Professor-plum/SAINTCON-BADGE-2026/README.md

# SAINTCON-BADGE-2026
Electronic badge for SAINTCON2026
