Professor-plum/SAINTCON-BADGE-2026/hardware/Apollo.kicad_pcb

## KiCad design hardware/Apollo.kicad_pcb (2026-10-26)

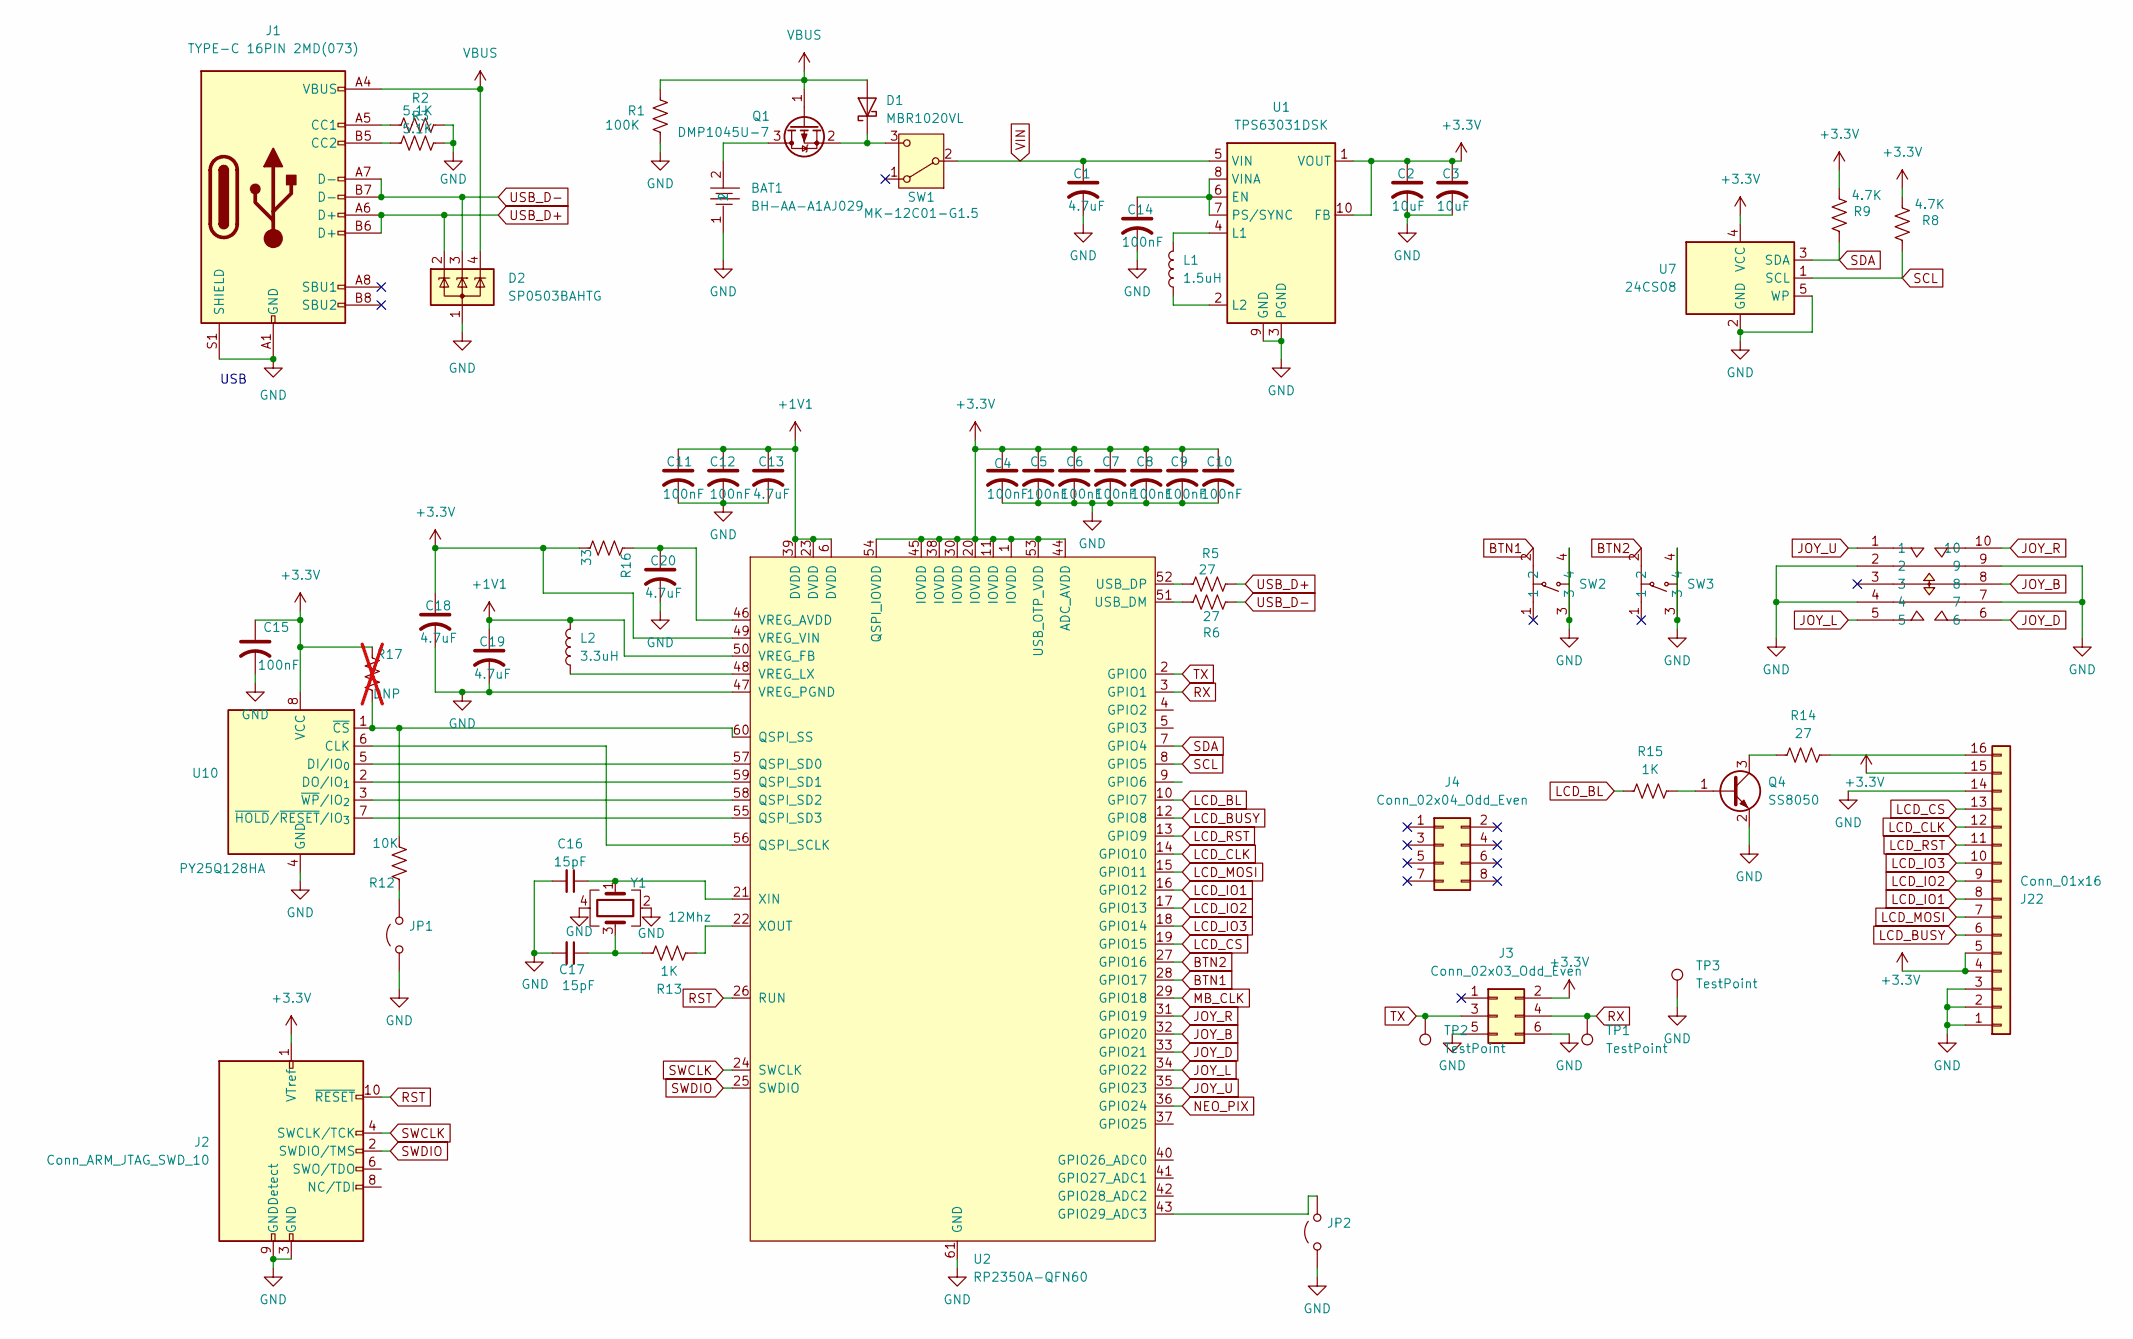
[picture p1: schematic mcu.kicad_sch, Apollo]

Parts:
BAT1: BH-AA-A1AJ029; BAT-TH_BH-AA-A1AJ029; LCSC Part C7525429
C1, C13, C18, C19, C20: 4.7uF; C_0603_1608Metric; LCSC Part C19666
C2, C3: 10uF; C_0603_1608Metric; LCSC Part C19702
C4, C5, C6, C7, C8, C9, C10, C11, C12, C14, C15: 100nF; C_0603_1608Metric; LCSC Part C1590
C16, C17: 15pF; C_0603_1608Metric; LCSC Part C1644
D1: MBR1020VL; D_SOD-123F; LCSC Part C49231015
D2: SP0503BAHTG; SOT-143; LCSC Part C7074
J1: TYPE-C 16PIN 2MD(073); USB_C_Receptacle_GCT_USB4105-xx-A_16P_TopMnt_Horizontal; LCSC Part C2765186
J2: Conn_ARM_JTAG_SWD_10; PinHeader_2x05_P1.27mm_Vertical_SMD
J3: Conn_02x03_Odd_Even; PCB_Edge_6
J4: Conn_02x04_Odd_Even; PCB_Edge_8
J22: Conn_01x16; FPC-SMD_16P-P0.50_KH-FPC0.5-H1.0SMT-16P; LCSC Part C3250117
JP1, JP2: Jumper_2_Open; SolderJumper-2_P1.3mm_Open_RoundedPad1.0x1.5mm
L1: 1.5uH; IND-SMD_L3.0-W3.0_FNR30XXS; LCSC Part C167745
L2: 3.3uH; IND-SMD_L2.0-W1.6_AOTA-B201610S3R3-101-T; LCSC Part C42411119
Q1: DMP1045U-7; SOT-23; LCSC Part C177033
Q4: SS8050; SOT-23; LCSC Part C2914407
R1: 100K; R_0603_1608Metric; LCSC Part C25803
R2, R3: 5.1K; R_0603_1608Metric; LCSC Part C2907044
R5, R6, R14: 27; R_0603_1608Metric; LCSC Part C2907021
R8, R9: 4.7K; R_0603_1608Metric; LCSC Part C23162
R12: 10K; R_0603_1608Metric; LCSC Part C25804
R13, R15: 1K; R_0603_1608Metric; LCSC Part C5362357
R16: 33; R_0603_1608Metric; LCSC Part C23140
R17: DNP; R_0603_1608Metric; not fitted
SW1: MK-12C01-G1.5; SW-SMD_DEALON_MK-12C01-G1.5; LCSC Part C2904924
SW2, SW3: TS-1095PS-A1B2-C3D2; KEY-SMD_4P-L6.0-W6.0-P3.90-LS9.0; LCSC Part C2834918
SW4: LCK-TKLYABE0G1; SW-SMD_10P-L10.6-W10.0_SKLYABE010; MPN LCK-TKLYABE0G1; LCSC Part C54769749
TP1, TP2, TP3: TestPoint; TestPoint_Pad_D1.0mm
U1: TPS63031DSK; WSON-10-1EP_2.5x2.5mm_P0.5mm_EP1.2x2mm; LCSC Part C15516
U2: RP2350A-QFN60; QFN-60-1EP_7x7mm_P0.4mm_EP3.4x3.4mm; LCSC Part C42411118
U7: 24CS08; SOT-23-5; LCSC Part C41408502
U10: PY25Q128HA; SOIC-8_5.3x5.3mm_P1.27mm; LCSC Part C5354566
Y1: 12Mhz; CRYSTAL-SMD_4P-L3.2-W2.5-BL; LCSC Part C20625731

Connections:
+1V1: C11.1, C12.1, C13.1, C19.1, L2.2, U2.6 (DVDD), U2.23 (DVDD), U2.39 (DVDD), U2.50 (VREG_FB)
+3.3V: C2.1, C3.1, C4.1, C5.1, C6.1, C7.1, C8.1, C9.1, C10.1, C15.1, C18.1, J2.1 (VTref), J3.2, J22.4, J22.5, J22.15, R8.2, R9.2, R16.2, R17.1, U1.1 (VOUT), U1.10 (FB), U2.1 (IOVDD), U2.11 (IOVDD), U2.20 (IOVDD), U2.30 (IOVDD), U2.38 (IOVDD), U2.44 (ADC_AVDD), U2.45 (IOVDD), U2.49 (VREG_VIN), U2.53 (USB_OTP_VDD), U2.54 (QSPI_IOVDD), U7.4 (VCC), U10.8 (VCC); also elsewhere on the board
BTN1: SW2.2, U2.28 (GPIO17)
BTN2: SW3.2, U2.27 (GPIO16)
GND: BAT1.1, C1.2, C2.2, C3.2, C4.2, C5.2, C6.2, C7.2, C8.2, C9.2, C10.2, C11.2, C12.2, C13.2, C14.2, C15.2, C16.2, C17.2, C18.2, C19.2, C20.2, D2.1 (A), J1.A1 (GND), J1.A12 (GND), J1.B1 (GND), J1.B12 (GND), J1.S1 (SHIELD), J2.3 (GND), J2.5 (GND), J2.9 (GNDDetect), J3.5, J3.6, J22.1, J22.2, J22.3, J22.14, JP1.1 (A), JP2.1 (A), Q4.2 (E), R1.1, R2.2, R3.2, SW2.3, SW2.4, SW3.3, SW3.4, SW4.2, SW4.4, SW4.7, SW4.9, TP3.1 (1_1), U1.3 (PGND), U1.9 (GND), U1.11 (PGND), U2.47 (VREG_PGND), U2.61 (GND), U7.2 (GND), U7.5 (WP), U10.4 (GND), Y1.2, Y1.4; also elsewhere on the board
JOY_B: SW4.8, U2.32 (GPIO20)
JOY_D: SW4.6, U2.33 (GPIO21)
JOY_L: SW4.5, U2.34 (GPIO22)
JOY_R: SW4.10, U2.31 (GPIO19)
JOY_U: SW4.1, U2.35 (GPIO23)
LCD_BL: R15.1, U2.10 (GPIO7)
LCD_BUSY: J22.6, U2.12 (GPIO8)
LCD_CLK: J22.12, U2.14 (GPIO10)
LCD_CS: J22.13, U2.19 (GPIO15)
LCD_IO1: J22.8, U2.16 (GPIO12)
LCD_IO2: J22.9, U2.17 (GPIO13)
LCD_IO3: J22.10, U2.18 (GPIO14)
LCD_MOSI: J22.7, U2.15 (GPIO11)
LCD_RST: J22.11, U2.13 (GPIO9)
MB_CLK: U2.29 (GPIO18); also elsewhere on the board
NEO_PIX: U2.36 (GPIO24); also elsewhere on the board
unnamed: C17.1, R13.1, Y1.3
unnamed: D1.1 (K), Q1.2 (S), SW1.3 (C)
unnamed: J1.A5 (CC1), R2.1
unnamed: J1.B5 (CC2), R3.1
unnamed: J22.16, R14.2
unnamed: JP1.2 (B), R12.1
unnamed: JP2.2 (B), U2.43 (GPIO29_ADC3)
unnamed: BAT1.2, Q1.3 (D)
unnamed: Q4.1 (B), R15.2
unnamed: Q4.3 (C), R14.1
unnamed: C14.1, U1.6 (EN), U1.7 (PS/SYNC), U1.8 (VINA)
unnamed: L1.2, U1.4 (L1)
unnamed: L1.1, U1.2 (L2)
unnamed: R6.2, U2.51 (USB_DM)
unnamed: R5.1, U2.52 (USB_DP)
unnamed: C20.1, R16.1, U2.46 (VREG_AVDD)
unnamed: L2.1, U2.48 (VREG_LX)
unnamed: C16.1, U2.21 (XIN), Y1.1
unnamed: R13.2, U2.22 (XOUT)
unnamed: U2.56 (QSPI_SCLK), U10.6 (CLK)
unnamed: U2.57 (QSPI_SD0), U10.5 (DI/IO_{0})
unnamed: U2.59 (QSPI_SD1), U10.2 (DO/IO_{1})
unnamed: R12.2, R17.2, U2.60 (QSPI_SS), U10.1 (~CS)
unnamed: U2.55 (QSPI_SD3), U10.7 (~HOLD/~RESET/IO_{3})
unnamed: U2.58 (QSPI_SD2), U10.3 (~WP/IO_{2})
RST: J2.10 (~RESET), U2.26 (RUN)
RX: J3.4, TP1.1 (1_1), U2.3 (GPIO1)
SCL: R8.1, U2.8 (GPIO5), U7.1 (SCL); also elsewhere on the board
SDA: R9.1, U2.7 (GPIO4), U7.3 (SDA); also elsewhere on the board
SWCLK: J2.4 (SWCLK/TCK), U2.24 (SWCLK)
SWDIO: J2.2 (SWDIO/TMS), U2.25 (SWDIO)
TX: J3.3, TP2.1 (1_1), U2.2 (GPIO0)
USB_D+: D2.2 (K), J1.A6 (D+), J1.B6 (D+), R5.2
USB_D-: D2.3 (K), J1.A7 (D-), J1.B7 (D-), R6.1
VBUS: D1.2 (A), D2.4 (K), J1.A4 (VBUS), J1.A9 (VBUS), J1.B4 (VBUS), J1.B9 (VBUS), Q1.1 (G), R1.2
VIN: C1.1, SW1.2 (B), U1.5 (VIN)

Notes on the sheet:
USB

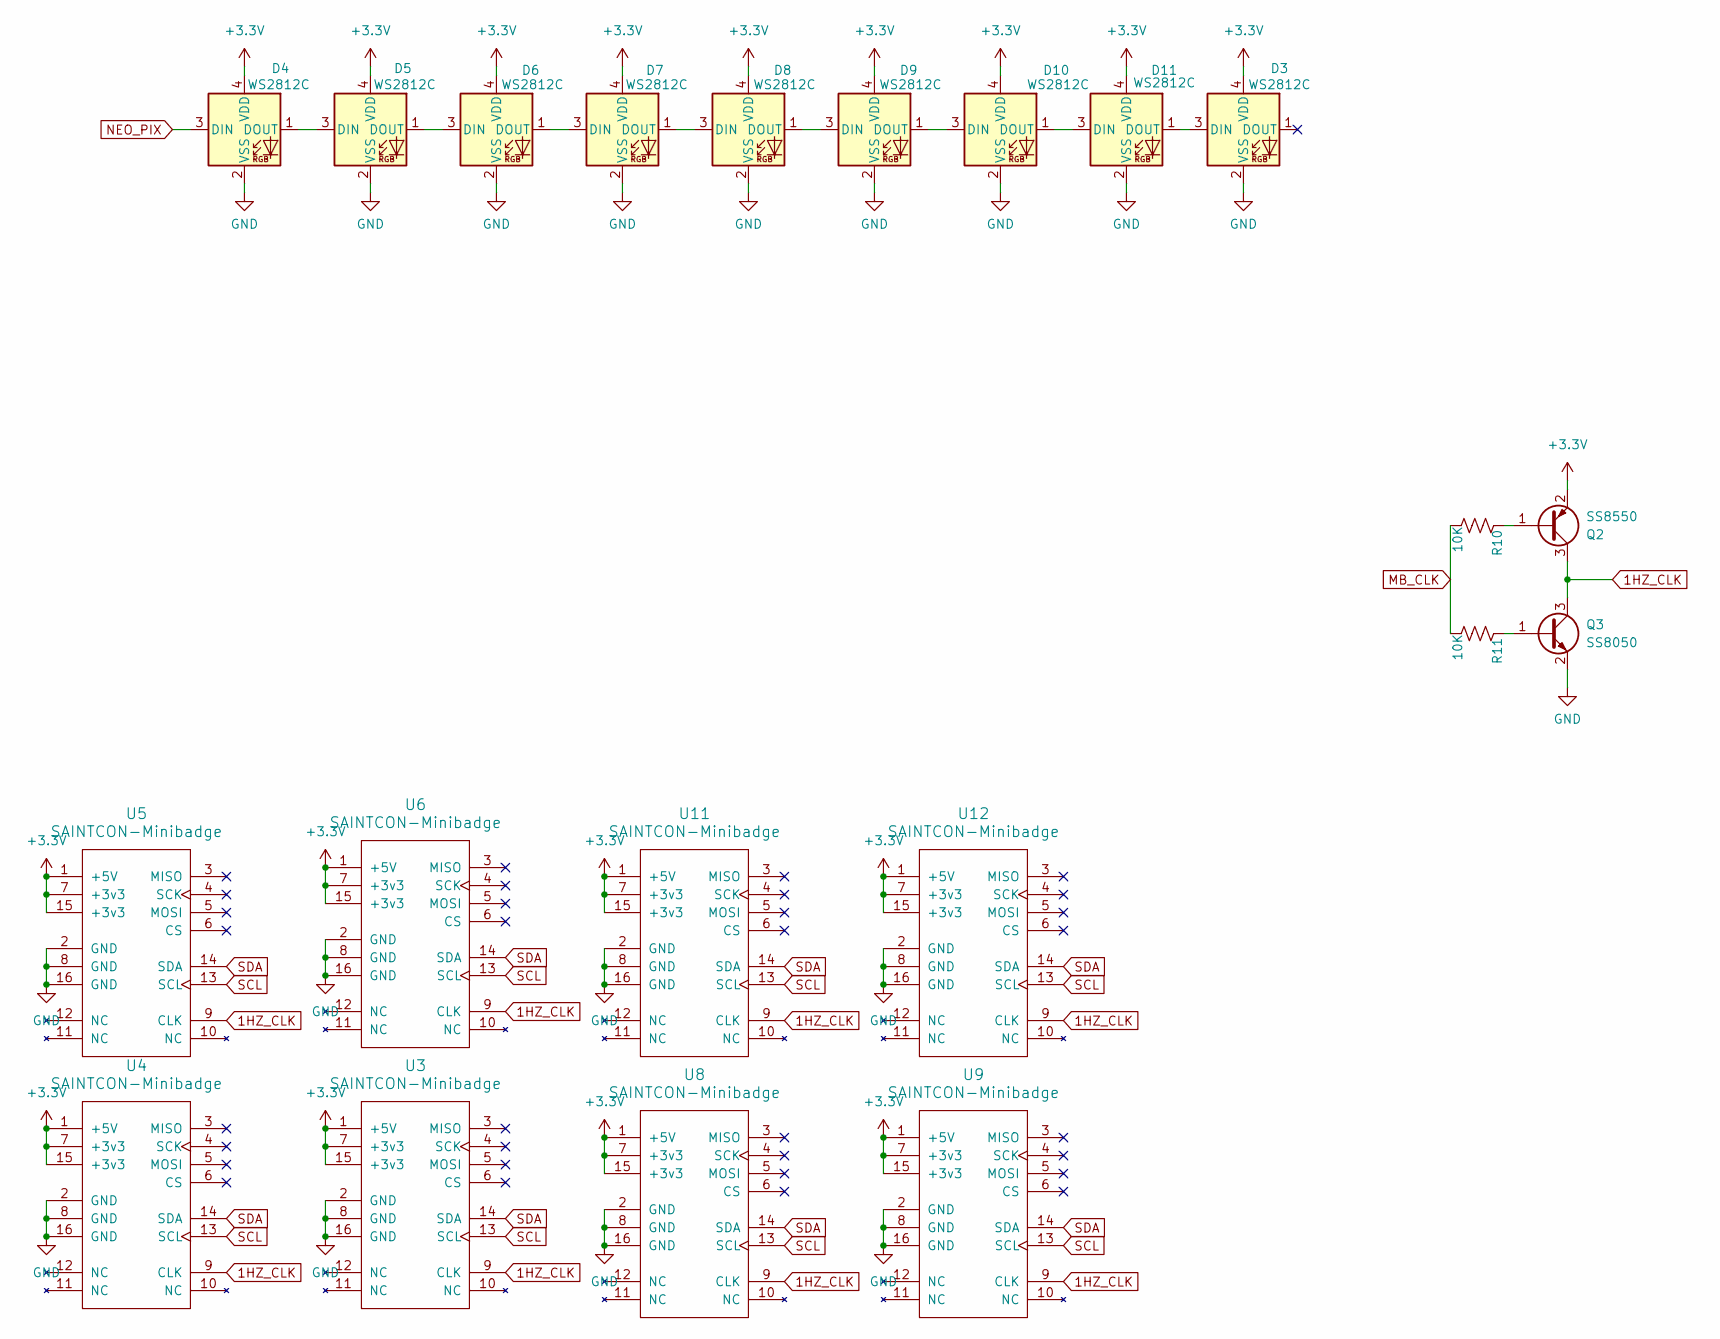
[picture p2: schematic i2c.kicad_sch, Apollo]

Parts:
D3, D4, D5, D6, D7, D8, D9, D10, D11: WS2812C; LED_WS2812B-2020_PLCC4_2.0x2.0mm; LCSC Part C2976072
Q2: SS8550; SOT-23; LCSC Part C916393
Q3: SS8050; SOT-23; LCSC Part C2914407
R10, R11: 10K; R_0603_1608Metric; LCSC Part C25804
U3, U4, U5, U6, U8, U9, U11, U12: SAINTCON-Minibadge; MiniBadge_Slot_Lock

Connections:
1HZ_CLK: Q2.3 (C), Q3.3 (C), U3.9 (CLK), U4.9 (CLK), U5.9 (CLK), U6.9 (CLK), U8.9 (CLK), U9.9 (CLK), U11.9 (CLK), U12.9 (CLK)
+3.3V: D3.4 (VDD), D4.4 (VDD), D5.4 (VDD), D6.4 (VDD), D7.4 (VDD), D8.4 (VDD), D9.4 (VDD), D10.4 (VDD), D11.4 (VDD), Q2.2 (E), U3.1 (+5V), U3.7 (+3v3), U3.15 (+3v3), U4.1 (+5V), U4.7 (+3v3), U4.15 (+3v3), U5.1 (+5V), U5.7 (+3v3), U5.15 (+3v3), U6.1 (+5V), U6.7 (+3v3), U6.15 (+3v3), U8.1 (+5V), U8.7 (+3v3), U8.15 (+3v3), U9.1 (+5V), U9.7 (+3v3), U9.15 (+3v3), U11.1 (+5V), U11.7 (+3v3), U11.15 (+3v3), U12.1 (+5V), U12.7 (+3v3), U12.15 (+3v3); also elsewhere on the board
GND: D3.2 (VSS), D4.2 (VSS), D5.2 (VSS), D6.2 (VSS), D7.2 (VSS), D8.2 (VSS), D9.2 (VSS), D10.2 (VSS), D11.2 (VSS), Q3.2 (E), U3.2 (GND), U3.8 (GND), U3.16 (GND), U4.2 (GND), U4.8 (GND), U4.16 (GND), U5.2 (GND), U5.8 (GND), U5.16 (GND), U6.2 (GND), U6.8 (GND), U6.16 (GND), U8.2 (GND), U8.8 (GND), U8.16 (GND), U9.2 (GND), U9.8 (GND), U9.16 (GND), U11.2 (GND), U11.8 (GND), U11.16 (GND), U12.2 (GND), U12.8 (GND), U12.16 (GND); also elsewhere on the board
MB_CLK: R10.2, R11.2; also elsewhere on the board
NEO_PIX: D4.3 (DIN); also elsewhere on the board
unnamed: D4.1 (DOUT), D5.3 (DIN)
unnamed: D5.1 (DOUT), D6.3 (DIN)
unnamed: D6.1 (DOUT), D7.3 (DIN)
unnamed: D7.1 (DOUT), D8.3 (DIN)
unnamed: D8.1 (DOUT), D9.3 (DIN)
unnamed: D9.1 (DOUT), D10.3 (DIN)
unnamed: D10.1 (DOUT), D11.3 (DIN)
unnamed: D3.3 (DIN), D11.1 (DOUT)
unnamed: Q2.1 (B), R10.1
unnamed: Q3.1 (B), R11.1
SCL: U3.13 (SCL), U4.13 (SCL), U5.13 (SCL), U6.13 (SCL), U8.13 (SCL), U9.13 (SCL), U11.13 (SCL), U12.13 (SCL); also elsewhere on the board
SDA: U3.14 (SDA), U4.14 (SDA), U5.14 (SDA), U6.14 (SDA), U8.14 (SDA), U9.14 (SDA), U11.14 (SDA), U12.14 (SDA); also elsewhere on the board

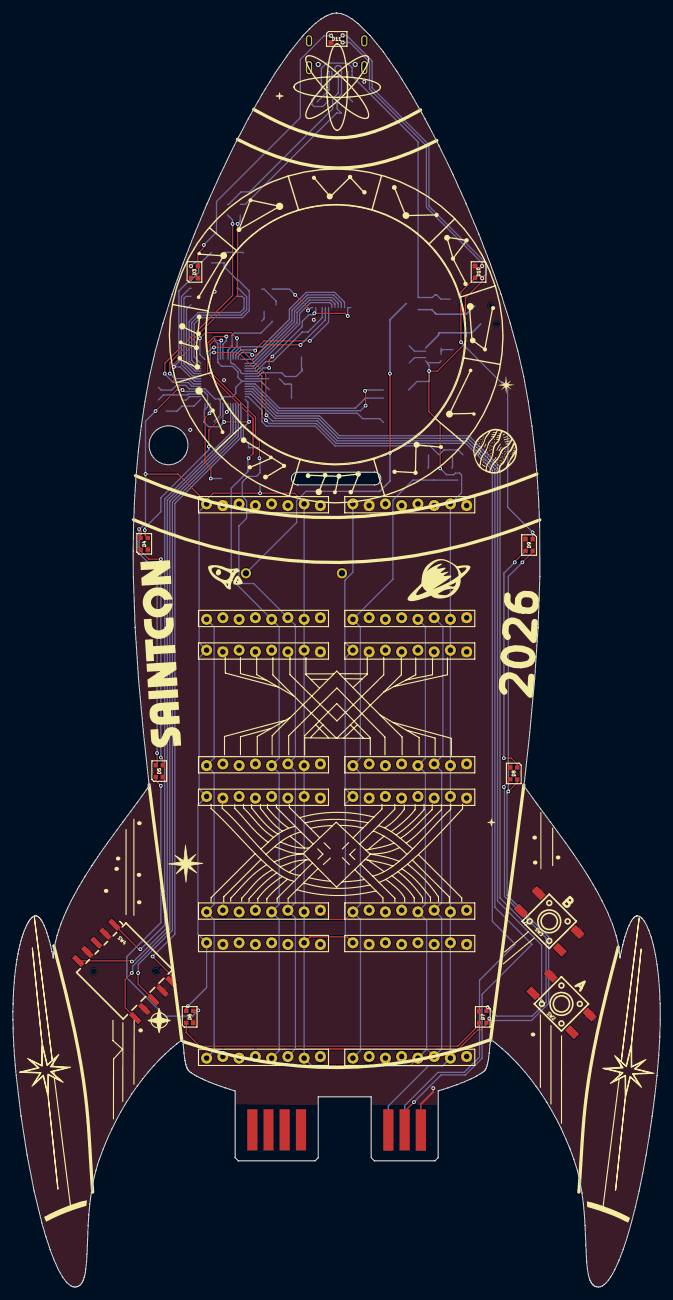
[picture p3: board Apollo.kicad_pcb from above]

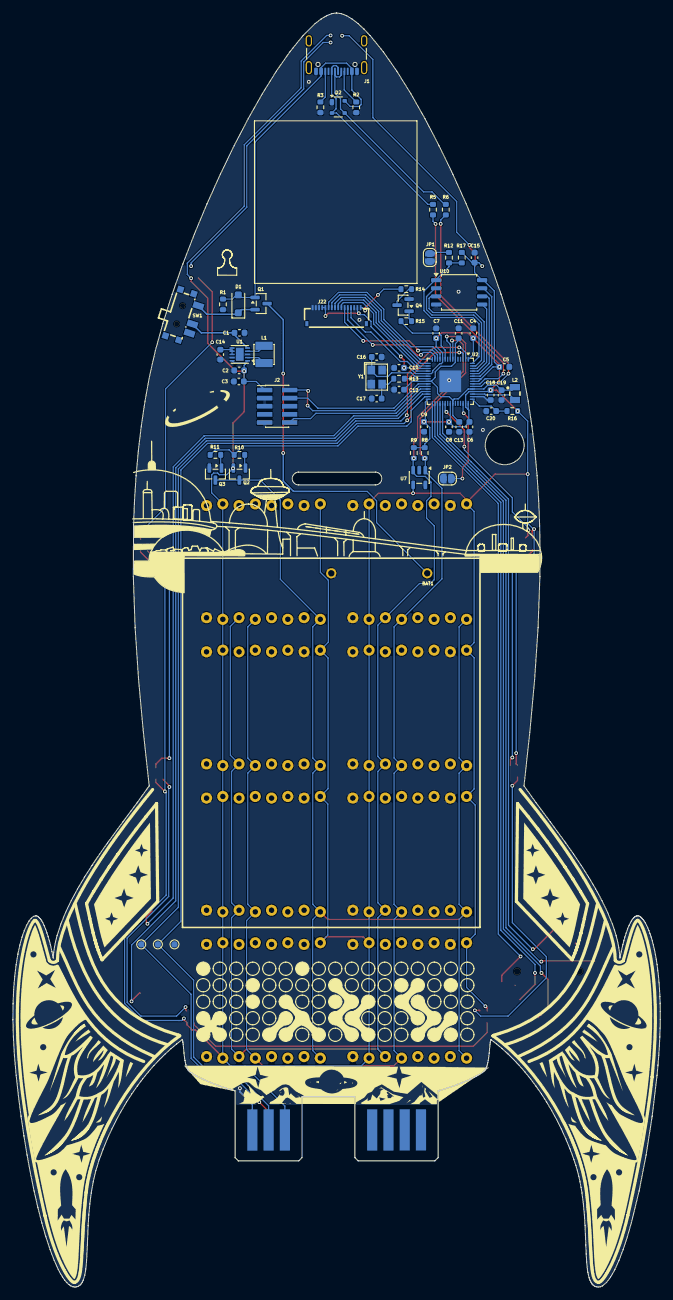
[picture p4: board Apollo.kicad_pcb from below]

Board: 2 copper layers, 101.2 x 199.1 mm, 80 parts (58 on the bottom side), 68 nets.
