Professor-plum/SAINTCON-BADGE-2026/hardware/Station/Station/Station.kicad_pcb

## KiCad design hardware/Station/Station/Station.kicad_pcb (2026-10-26)

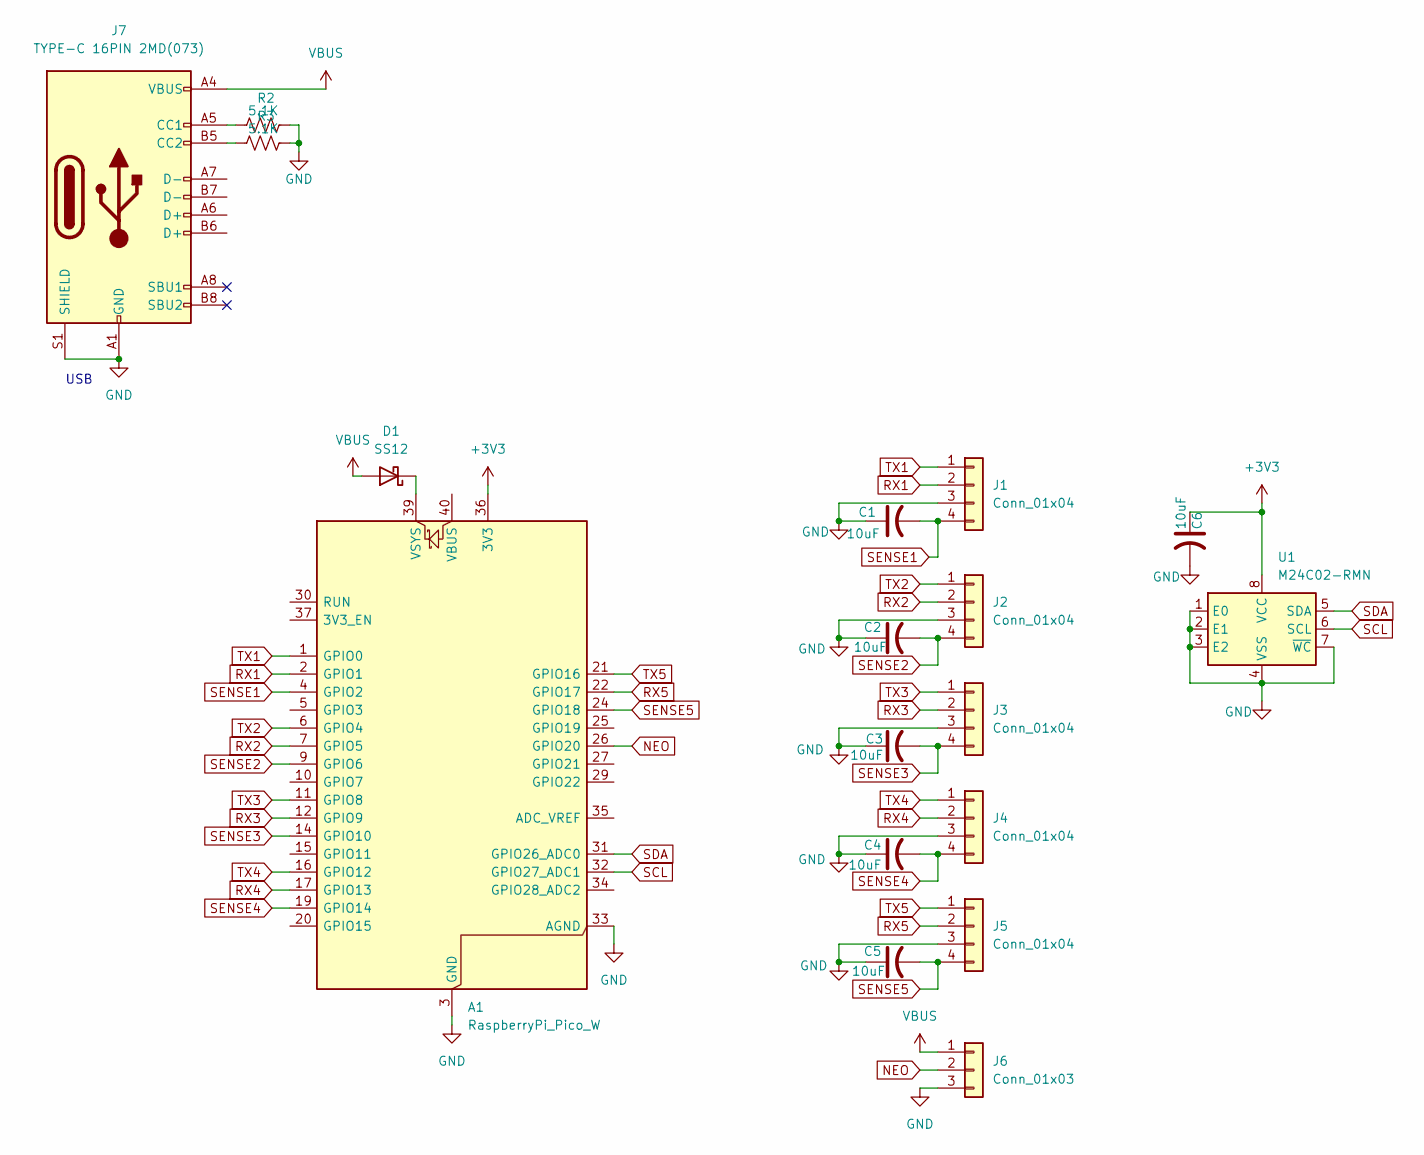
[picture p5: schematic Station.kicad_sch]

Parts:
A1: RaspberryPi_Pico_W; RaspberryPi_Pico_W_SMD_HandSolder
C1, C2, C3, C4, C5, C6: 10uF; C_0603_1608Metric_Pad1.08x0.95mm_HandSolder
D1: SS12; D_SMA
J1, J2, J3, J4, J5: Conn_01x04; PinHeader_1x04_P2.54mm_Vertical
J6: Conn_01x03; PinHeader_1x03_P2.54mm_Vertical
J7: TYPE-C 16PIN 2MD(073); USB_C_Receptacle_GCT_USB4105-xx-A_16P_TopMnt_Horizontal; LCSC Part C2765186
R2, R3: 5.1K; R_0603_1608Metric; LCSC Part C2907044
U1: M24C02-RMN; SOIC-8_3.9x4.9mm_P1.27mm

Connections:
+3V3: A1.36 (3V3), C6.1, U1.8 (VCC)
GND: A1.3 (GND), A1.8 (GND), A1.13 (GND), A1.18 (GND), A1.23 (GND), A1.28 (GND), A1.33 (AGND), A1.38 (GND), C1.1, C2.1, C3.1, C4.1, C5.1, C6.2, J1.3, J2.3, J3.3, J4.3, J5.3, J6.3, J7.A1 (GND), J7.A12 (GND), J7.B1 (GND), J7.B12 (GND), J7.S1 (SHIELD), R2.2, R3.2, U1.1 (E0), U1.2 (E1), U1.3 (E2), U1.4 (VSS), U1.7 (~WC)
NEO: A1.26 (GPIO20), J6.2
unnamed: A1.39 (VSYS), D1.1 (K)
unnamed: J7.A5 (CC1), R2.1
unnamed: J7.B5 (CC2), R3.1
RX1: A1.2 (GPIO1), J1.2
RX2: A1.7 (GPIO5), J2.2
RX3: A1.12 (GPIO9), J3.2
RX4: A1.17 (GPIO13), J4.2
RX5: A1.22 (GPIO17), J5.2
SCL: A1.32 (GPIO27_ADC1), U1.6 (SCL)
SDA: A1.31 (GPIO26_ADC0), U1.5 (SDA)
SENSE1: A1.4 (GPIO2), C1.2, J1.4
SENSE2: A1.9 (GPIO6), C2.2, J2.4
SENSE3: A1.14 (GPIO10), C3.2, J3.4
SENSE4: A1.19 (GPIO14), C4.2, J4.4
SENSE5: A1.24 (GPIO18), C5.2, J5.4
TX1: A1.1 (GPIO0), J1.1
TX2: A1.6 (GPIO4), J2.1
TX3: A1.11 (GPIO8), J3.1
TX4: A1.16 (GPIO12), J4.1
TX5: A1.21 (GPIO16), J5.1
VBUS: D1.2 (A), J6.1, J7.A4 (VBUS), J7.A9 (VBUS), J7.B4 (VBUS), J7.B9 (VBUS)

Notes on the sheet:
USB

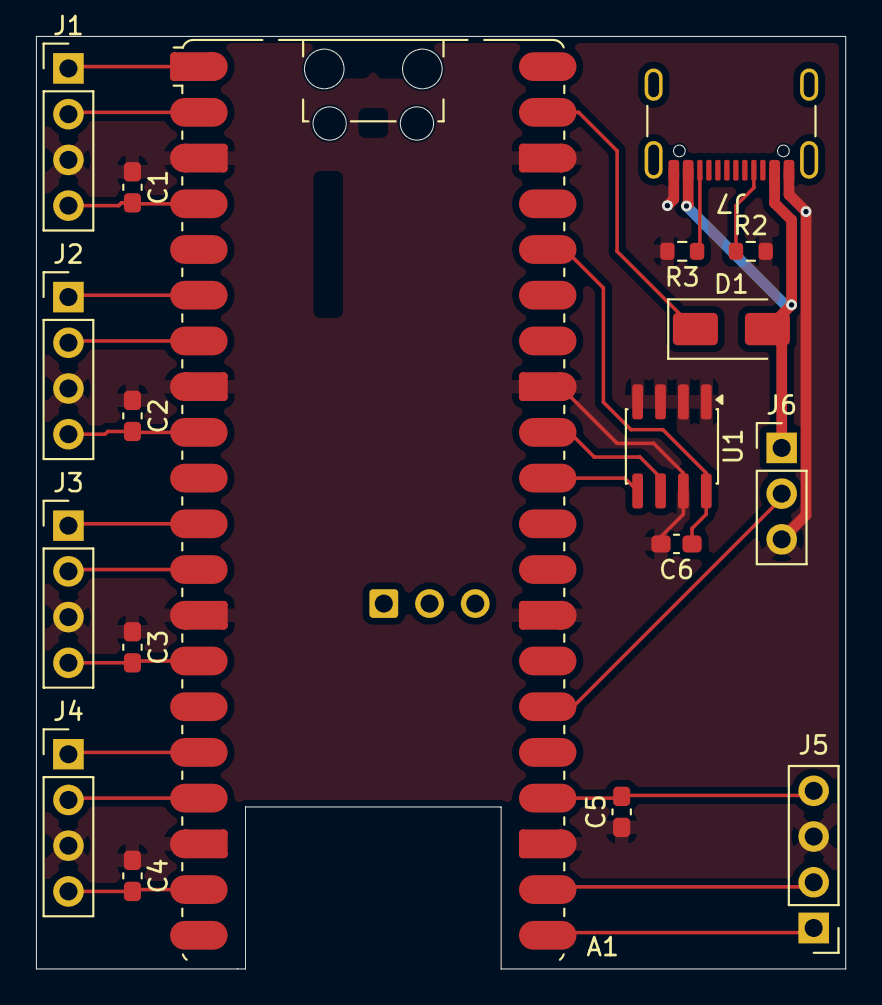
[picture p6: board Station.kicad_pcb from above]

Board: 2 copper layers, 45.0 x 51.8 mm, 18 parts (0 on the bottom side), 24 nets.
