Professor-plum/SAINTCON-BADGE-2026/hardware/Connector/Connector.kicad_pcb

## KiCad design hardware/Connector/Connector.kicad_pcb (2026-07-17)

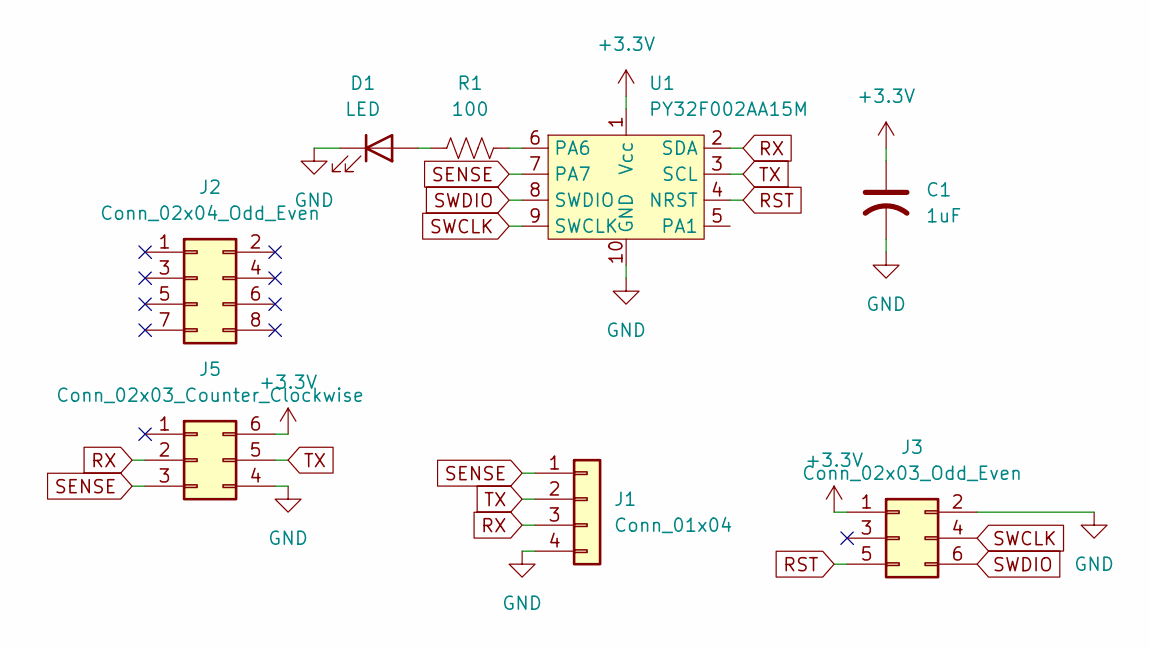
[picture p7: schematic Connector.kicad_sch]

Parts:
C1: 1uF; C_0603_1608Metric
D1: LED; LED_0603_1608Metric
J1: Conn_01x04; RJ45-TH_RRCH-52014P4C
J2: Conn_02x04_Odd_Even; CONN-TH_ER08BGFBK
J3: Conn_02x03_Odd_Even; PinHeader_2x03_P1.27mm_Vertical
J5: Conn_02x03_Counter_Clockwise; CONN-TH_6P-P2.54_ER06BGFBK
R1: 100; R_0603_1608Metric
U1: PY32F002AA15M; SSOP-10_3.9x4.9mm_P1.00mm

Connections:
+3.3V: C1.1, J3.1, J5.6, U1.1 (Vcc)
GND: C1.2, D1.1 (K), J1.4, J3.2, J5.4, U1.10 (GND)
unnamed: D1.2 (A), R1.2
unnamed: R1.1, U1.6 (PA6)
RST: J3.5, U1.4 (NRST)
RX: J1.3, J5.2, U1.2 (SDA)
SENSE: J1.1, J5.3, U1.7 (PA7)
SWCLK: J3.4, U1.9 (SWCLK)
SWDIO: J3.6, U1.8 (SWDIO)
TX: J1.2, J5.5, U1.3 (SCL)

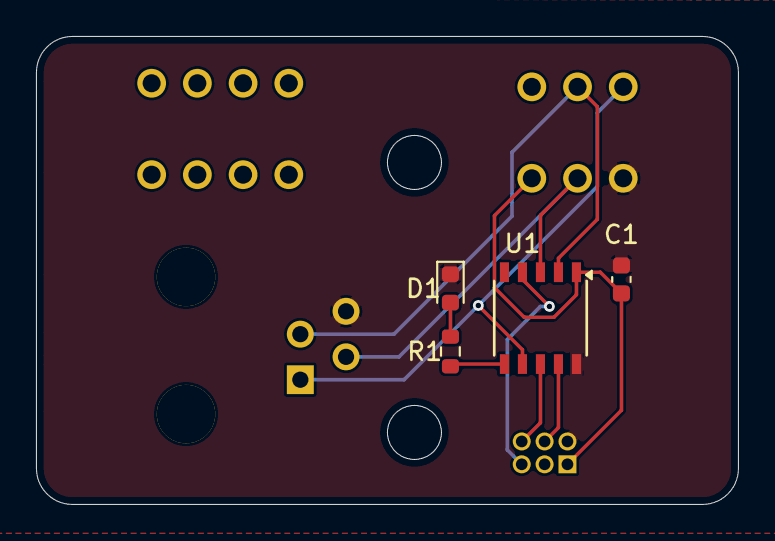
[picture p8: board Connector.kicad_pcb from above]

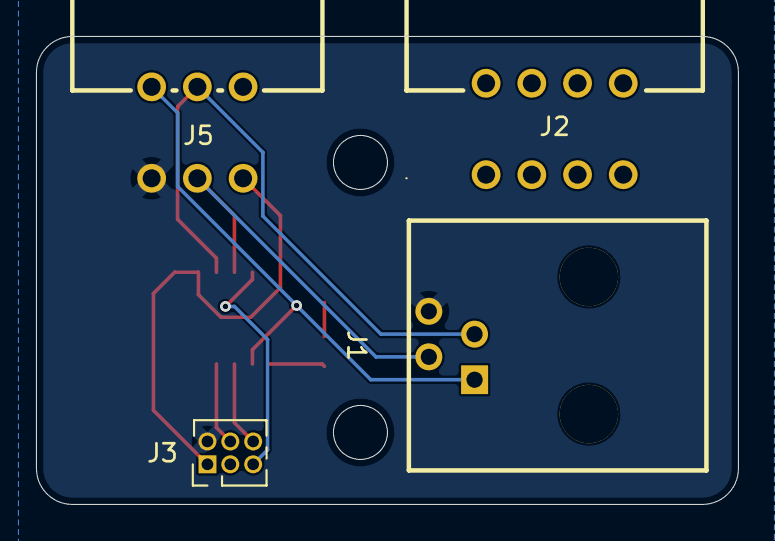
[picture p9: board Connector.kicad_pcb from below]

Board: 2 copper layers, 39.0 x 26.0 mm, 8 parts (4 on the bottom side), 10 nets.
