Professor-plum/SAINTCON-BADGE-2026/firmware/bsp/CCRegeneration8pt7b.h

#include "gfxfont.h"

const uint8_t CCRegeneration8pt7bBitmaps[] PROGMEM = {
  0x00, 0xFF, 0xFF, 0xFF, 0xE0, 0x7E, 0xEE, 0xD9, 0xB3, 0x60, 0x77, 0x77,
  0xFF, 0xFF, 0x77, 0x77, 0xFF, 0xFF, 0x77, 0x77, 0x30, 0x78, 0xCC, 0xCC,
  0xC0, 0xDC, 0xCC, 0xC0, 0xCC, 0xCC, 0x78, 0x30, 0x30, 0x78, 0xE3, 0xF7,
  0x0C, 0xDC, 0x33, 0x70, 0xFF, 0x81, 0xEE, 0x00, 0x37, 0x81, 0xDE, 0x07,
  0xCC, 0x3B, 0x30, 0xEC, 0xC3, 0x9E, 0x1C, 0x78, 0x3F, 0x1F, 0xC7, 0x01,
  0xC0, 0x70, 0x1F, 0xF7, 0xFF, 0xCE, 0xE3, 0xB8, 0xEE, 0x39, 0xFE, 0x3F,
  0x80, 0x6D, 0xB0, 0x19, 0xDC, 0xEE, 0x73, 0x9C, 0xE7, 0x1C, 0xE3, 0x8C,
  0xC3, 0xC7, 0x8E, 0x1C, 0x71, 0xC7, 0x1C, 0xF3, 0x9E, 0xF3, 0x80, 0x5A,
  0xFF, 0x7E, 0x3C, 0x7E, 0xFF, 0x5A, 0x38, 0x38, 0x38, 0xFF, 0xFF, 0x38,
  0x38, 0x38, 0x3B, 0x98, 0xC0, 0xFF, 0xFC, 0x0E, 0x1C, 0x70, 0xE1, 0xC7,
  0x0E, 0x1C, 0x70, 0xE1, 0xC7, 0x0E, 0x00, 0x1F, 0x07, 0xF1, 0xC7, 0x38,
  0xEE, 0x0F, 0xC1, 0xF8, 0x3F, 0x07, 0xE0, 0xEE, 0x39, 0xC7, 0x1F, 0xC1,
  0xF0, 0xFF, 0x77, 0x77, 0x77, 0x77, 0x77, 0x70, 0x7C, 0x7E, 0x07, 0x07,
  0x0F, 0x3F, 0x7E, 0xFC, 0xF0, 0xE0, 0xE0, 0xFF, 0xFF, 0xFC, 0xFE, 0x0E,
  0x06, 0x0E, 0x3E, 0x3E, 0x07, 0x07, 0x07, 0x07, 0xFE, 0xFC, 0xE7, 0x73,
  0xB9, 0xDC, 0xEE, 0x77, 0xFF, 0xFE, 0x0E, 0x07, 0x03, 0x81, 0xC0, 0xE0,
  0x70, 0xFE, 0xFE, 0xE0, 0xE0, 0xE0, 0xFC, 0xFE, 0x07, 0x07, 0x07, 0x07,
  0xFE, 0xFC, 0x1E, 0x0F, 0x87, 0x01, 0x80, 0xDF, 0x3F, 0xEF, 0x3F, 0x87,
  0xE1, 0xF8, 0x77, 0x3C, 0xFE, 0x1F, 0x00, 0xFF, 0xFF, 0x83, 0xC1, 0xC0,
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
  {   407,   8,  13,  10,    1,  -12 },   // 0x46 'F'
  {   420,  10,  13,  12,    1,  -12 },   // 0x47 'G'
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

const GFXfont CCRegeneration8pt7b PROGMEM = {
  (uint8_t  *)CCRegeneration8pt7bBitmaps,
  (GFXglyph *)CCRegeneration8pt7bGlyphs,
  0x20, 0x7E, 19 };

// Approx. 1776 bytes
