Professor-plum/SAINTCON-BADGE-2026/firmware/bsp/Nasalization_Rg8pt7b.h

const uint8_t Nasalization_Rg8pt7bBitmaps[] PROGMEM = {
  0x00, 0xFF, 0xFC, 0x30, 0xDE, 0xF7, 0xB0, 0x22, 0x22, 0xFF, 0x22, 0x22,
  0x22, 0xFF, 0x22, 0x22, 0x22, 0x10, 0x10, 0x7F, 0xC0, 0xC0, 0xC0, 0x7E,
  0x03, 0x03, 0xFE, 0x10, 0x10, 0x70, 0x48, 0x88, 0x89, 0x88, 0x90, 0x72,
  0xE0, 0x51, 0x09, 0x11, 0x91, 0x11, 0x12, 0x0E, 0x1F, 0x06, 0x30, 0xC6,
  0x18, 0xC1, 0xF0, 0x38, 0x1D, 0x9F, 0x36, 0xC3, 0x98, 0x79, 0xFB, 0x80,
  0xFF, 0x3A, 0x21, 0x08, 0x42, 0x10, 0x84, 0x21, 0x08, 0x42, 0x08, 0x38,
  0xE0, 0x82, 0x10, 0x84, 0x21, 0x08, 0x42, 0x10, 0x84, 0x22, 0xE0, 0x11,
  0x27, 0x59, 0xC7, 0xF2, 0x44, 0x00, 0x08, 0x08, 0x08, 0xFF, 0x08, 0x08,
  0x08, 0x08, 0x6D, 0xBC, 0xFC, 0xC0, 0x06, 0x08, 0x30, 0x60, 0x83, 0x06,
  0x08, 0x30, 0x41, 0x83, 0x04, 0x18, 0x00, 0x3F, 0x18, 0x6C, 0x0F, 0x03,
  0xC0, 0xF0, 0x3C, 0x0F, 0x03, 0x61, 0x8F, 0xC0, 0xE3, 0x33, 0x33, 0x33,
  0x33, 0xFF, 0x80, 0x30, 0x0C, 0x0F, 0x3F, 0xFF, 0xEF, 0x83, 0x00, 0xC0,
  0x3F, 0xF0, 0xFF, 0x00, 0xC0, 0x60, 0x33, 0xE0, 0x0C, 0x06, 0x03, 0x01,
  0xFF, 0x80, 0x07, 0xC3, 0x31, 0x8C, 0xC3, 0x70, 0xD8, 0x36, 0x0D, 0xFF,
  0x00, 0xC0, 0x30, 0xFF, 0x60, 0x30, 0x18, 0x0F, 0xF0, 0x0C, 0x06, 0x03,
  0x01, 0xFF, 0x80, 0x3F, 0x98, 0x0C, 0x03, 0x00, 0xFF, 0xB0, 0x3C, 0x0F,
  0x03, 0x61, 0xCF, 0xE0, 0xFF, 0x00, 0xC0, 0x60, 0x70, 0x70, 0x30, 0x30,
  0x38, 0x38, 0x18, 0x00, 0x7F, 0xB0, 0x3C, 0x0F, 0x03, 0x3F, 0x30, 0x3C,
  0x0F, 0x03, 0xC0, 0xDF, 0xE0, 0x7E, 0x61, 0xB0, 0x78, 0x3C, 0x1B, 0xFC,
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
  {   352,   9,  10,  10,    1,   -9 },   // 0x46 'F'
  {   364,  10,  10,  12,    1,   -9 },   // 0x47 'G'
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

const GFXfont Nasalization_Rg8pt7b PROGMEM = {
  (uint8_t  *)Nasalization_Rg8pt7bBitmaps,
  (GFXglyph *)Nasalization_Rg8pt7bGlyphs,
  0x20, 0x7E, 19 };

// Approx. 1615 bytes
