Professor-plum/SAINTCON-BADGE-2026/firmware/crew.c

#include "img/crew.h"
#include "framebuffer.h"

unsigned short get_crew_color(const char c) {
    switch(c) {
        case 'A': return RGB565(0, 0, 150);   //Pilot = Blue
        case 'B': return RGB565(150, 75, 0);  //Engineer = Orange
        case 'C': return RGB565(150, 150, 150);   //Scientist = White
        case 'D': return RGB565(0, 150, 0);   //Soldier = Green
        case 'E': return RGB565(150, 75, 75);   //Medic = Pink
        default: return RGB565(150, 0, 150);    //Purple  
    }
};

 

const unsigned short player_img_data[5][240] = {
    {
0x0000, 0x0000, 0x0000, 0x0000, 0x0B17, 0x0AF7, 0x0B17, 0x0B16, 0x0B17, 0x0B17, 0x0B17, 0x0000, 
0x0000, 0x0000, 0x0000, 0x0000, 0x0000, 0x0000, 0x0B37, 0x09EE, 0x020F, 0x09EE, 0x0A0F, 0x09CD, 
0x09EE, 0x0A0F, 0x0B38, 0x0000, 0x0000, 0x0000, 0x0000, 0x0000, 0x0B37, 0x0A50, 0xF7BE, 0xCEDC, 
0xC6BC, 0x0AD5, 0xDF1C, 0xDF1D, 0xEF5D, 0x020F, 0x0B38, 0x0000, 0x0000, 0x0000, 0x0000, 0x01CE, 
0xCEDC, 0xE73D, 0xCEDC, 0xB61A, 0x0AD5, 0xCEBB, 0xEF7D, 0xCEBC, 0xC6BC, 0x01EE, 0x0000, 0x0000, 
0x0000, 0x0000, 0x09CD, 0x0A0E, 0x09CD, 0x09EE, 0x09AC, 0x08A3, 0x1127, 0x09EE, 0x09AC, 0x09EE, 
0x01AD, 0x0000, 0x0000, 0x0000, 0x01EF, 0x09AB, 0x10A2, 0x18C2, 0x18C3, 0x18C3, 0x18E3, 0x18E3, 
0x18C3, 0x1082, 0x0861, 0x01AD, 0x01EF, 0x0000, 0x02D5, 0x0A93, 0x014A, 0x0020, 0xECCB, 0xFE31, 
0xFE10, 0xFE10, 0xFDF0, 0xFE10, 0xF52D, 0x2081, 0x016A, 0x0252, 0x02B4, 0x0292, 0x0231, 0x0929, 
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
0x0020, 0x0040, 0x0040, 0x0041, 0x0041, 0x0061, 0x0061, 0x08C1, 0x2224, 0x64E9, 0x33A7, 0x00A0, 
0x0020, 0x0000, 0x0000, 0x0000, 0x0000, 0x19C3, 0x43A7, 0x2AA4, 0x0060, 0x4C28, 0x43E7, 0x1182, 
0x00C1, 0x0000, 0x0000, 0x0000, 0x0000, 0x0000, 0x0000, 0x0000, 0x0000, 0x0020, 0x0040, 0x0041, 
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
