Professor-plum/SAINTCON-BADGE-2026/firmware/bsp/GothiksRoundFont.h

#ifndef GOTHIKS_ROUND_FONT_H
#define GOTHIKS_ROUND_FONT_H
#include "gfxfont.h"


const uint8_t GothiksRoundTrial_Book8pt7bBitmaps[] PROGMEM = {
  0x00, 0xFF, 0xFE, 0x07, 0xF0, 0xFD, 0x9B, 0xCF, 0x3C, 0x63, 0xC6, 0x3C,
  0xF3, 0xD9, 0xBF, 0x0F, 0xE0, 0x7F, 0xFF, 0xFF, 0xFE, 0x07, 0xF0, 0xFD,
  0x9B, 0xCF, 0x3C, 0x63, 0xC6, 0x3C, 0xF3, 0xD9, 0xBF, 0x0F, 0xE0, 0x7F,
  0xFF, 0xFF, 0xFE, 0x07, 0xF0, 0xFD, 0x9B, 0xCF, 0x3C, 0x63, 0xC6, 0x3C,
  0xF3, 0xD9, 0xBF, 0x0F, 0xE0, 0x7F, 0xFF, 0xFF, 0xFE, 0x07, 0xF0, 0xFD,
  0x9B, 0xCF, 0x3C, 0x63, 0xC6, 0x3C, 0xF3, 0xD9, 0xBF, 0x0F, 0xE0, 0x7F,
  0xFF, 0xFF, 0xFE, 0x07, 0xF0, 0xFD, 0x9B, 0xCF, 0x3C, 0x63, 0xC6, 0x3C,
  0xF3, 0xD9, 0xBF, 0x0F, 0xE0, 0x7F, 0xFF, 0xFF, 0xFE, 0x07, 0xF0, 0xFD,
  0x9B, 0xCF, 0x3C, 0x63, 0xC6, 0x3C, 0xF3, 0xD9, 0xBF, 0x0F, 0xE0, 0x7F,
  0xFF, 0xFF, 0xFE, 0x07, 0xF0, 0xFD, 0x9B, 0xCF, 0x3C, 0x63, 0xC6, 0x3C,
  0xF3, 0xD9, 0xBF, 0x0F, 0xE0, 0x7F, 0xFF, 0xFF, 0xFE, 0x07, 0xF0, 0xFD,
  0x9B, 0xCF, 0x3C, 0x63, 0xC6, 0x3C, 0xF3, 0xD9, 0xBF, 0x0F, 0xE0, 0x7F,
  0xFF, 0xFF, 0xFE, 0x07, 0xF0, 0xFD, 0x9B, 0xCF, 0x3C, 0x63, 0xC6, 0x3C,
  0xF3, 0xD9, 0xBF, 0x0F, 0xE0, 0x7F, 0xFF, 0xFF, 0xFE, 0x07, 0xF0, 0xFD,
  0x9B, 0xCF, 0x3C, 0x63, 0xC6, 0x3C, 0xF3, 0xD9, 0xBF, 0x0F, 0xE0, 0x7F,
  0xFF, 0xFF, 0xFE, 0x07, 0xF0, 0xFD, 0x9B, 0xCF, 0x3C, 0x63, 0xC6, 0x3C,
  0xF3, 0xD9, 0xBF, 0x0F, 0xE0, 0x7F, 0xFF, 0xF8, 0xE0, 0xF0, 0xFF, 0xFE,
  0x07, 0xF0, 0xFD, 0x9B, 0xCF, 0x3C, 0x63, 0xC6, 0x3C, 0xF3, 0xD9, 0xBF,
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
  {   467,   5,  12,   7,    1,  -11 },   // 0x47 'G'
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

const GFXfont GothiksRoundTrial_Book8pt7b PROGMEM = {
  (uint8_t  *)GothiksRoundTrial_Book8pt7bBitmaps,
  (GFXglyph *)GothiksRoundTrial_Book8pt7bGlyphs,
  0x20, 0x7E, 19 };

// Approx. 1669 bytes

#endif // GOTHIKSROUNDFONT_H
