Professor-plum/SAINTCON-BADGE-2026/firmware/include/game.h

#ifndef GAME_H
#define GAME_H

#include "hexutils.h"
#include "eventbase.h"
#include "bsp/common.h"

#define POI_COUNT       9

typedef struct {
    int seed;
    int poi_market_rate[POI_COUNT];
    Hex poi[POI_COUNT];
    Hex nebula;
    Hex astroids[6];
    Hex player;
    int heading;
    int hull;
    int fuel;
    int credits;
    int cargo;
    int reputation;
    int xp;
} game_state_t;

typedef struct {
    int xp;
    game_character_t self;
    uint32_t achievments; // Bitfield for achievments
} persistant_state_t;

typedef struct {
    int max_fuel;
    int max_hull;
    int max_cargo;
    int starting_credits;
} game_config_t;

enum tiletype {
    TILE_EMPTY,
    TILE_NEBULA,
    TILE_ASTROID,
    TILE_HOME,
    TILE_POI
};

void game_run();

#endif // GAME_H
