Professor-plum/SAINTCON-BADGE-2026/firmware/include/outposts.h

#ifndef OUTPOSTS_H
#define OUTPOSTS_H

void outpost_core_run();
void outpost_solar_run();
void outpost_comms_run();
void outpost_archive_run();
void outpost_atmos_run();
void outpost_mine_run();
void outpost_bio_run();
void outpost_factory_run();
void outpost_gate_run();


#endif //OUTPOSTS_H
