Professor-plum/SAINTCON-BADGE-2026/(commit log)

2026-05-07 Added hardware design files
    [Apollo.kicad_pcb, Apollo.kicad_sch, Connector.kicad_pcb, Connector.kicad_sch, i2c.kicad_sch, mcu.kicad_sch]
2026-05-07 Move items out of subdirectory
    [Apollo.kicad_pcb, Apollo.kicad_sch, Connector.kicad_pcb, Connector.kicad_sch, i2c.kicad_sch, mcu.kicad_sch]
2026-05-24 prototype v0.3
    [Apollo.kicad_pcb, mcu.kicad_sch]
2026-05-24 Updated joystick
    [Apollo.kicad_pcb, mcu.kicad_sch]
2026-06-05 accel added
    [Apollo.kicad_pcb, i2c.kicad_sch]
2026-06-05 Restoring Orion trail
    [Apollo.kicad_pcb, i2c.kicad_sch, mcu.kicad_sch]
2026-06-13 Added achievement screen and minor edits
    [Apollo.kicad_pcb]
2026-06-19 Progress on station communications
    [Apollo.kicad_pcb, mcu.kicad_sch]
2026-07-17 Badge order placed. Hardware finalized
    [Apollo.kicad_pcb, Connector.kicad_pcb, Station.kicad_pcb, Station.kicad_sch, i2c.kicad_sch, mcu.kicad_sch]
2026-08-21 V1.0 firmware release
    [Station.kicad_pcb, Station.kicad_sch]
2026-08-23 Fix for slow Oscillator/flash settling
    [docking.c]
2026-10-26 Station update before con
    [Apollo.kicad_pcb, Station.kicad_pcb, Station.kicad_sch]
